jcarrus/MakeMITSelfBalancingRobot/segspecs/CAD/SolidWorks/segway1.jpg

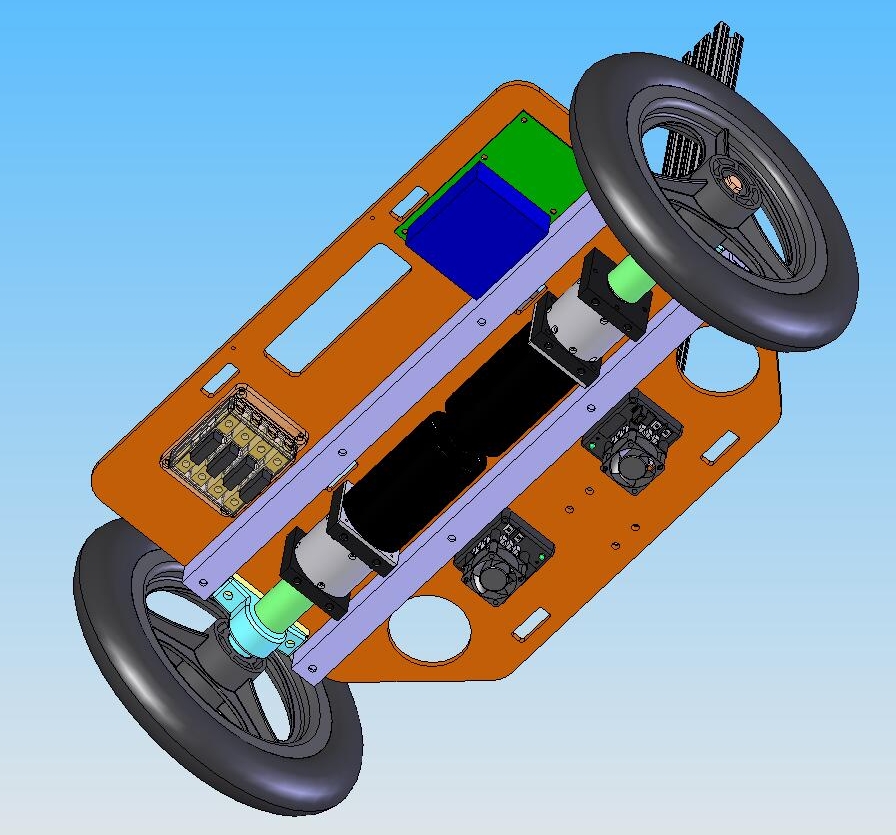
segspecs/CAD/SolidWorks/segway1.jpg
