jcarrus/MakeMITSelfBalancingRobot/segspecs/CAD/SolidWorks/segway2.jpg

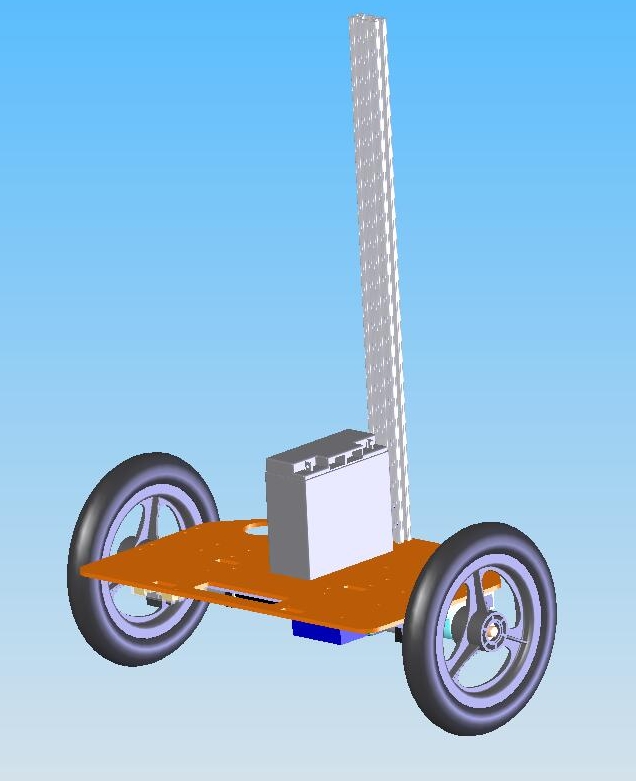
segspecs/CAD/SolidWorks/segway2.jpg
