jcarrus/MakeMITSelfBalancingRobot/README.md

MakeMITSelfBalancingRobot
=========================
