jcarrus/MakeMITSelfBalancingRobot/segspecs/CAD/SolidWorks/handlebar.jpg

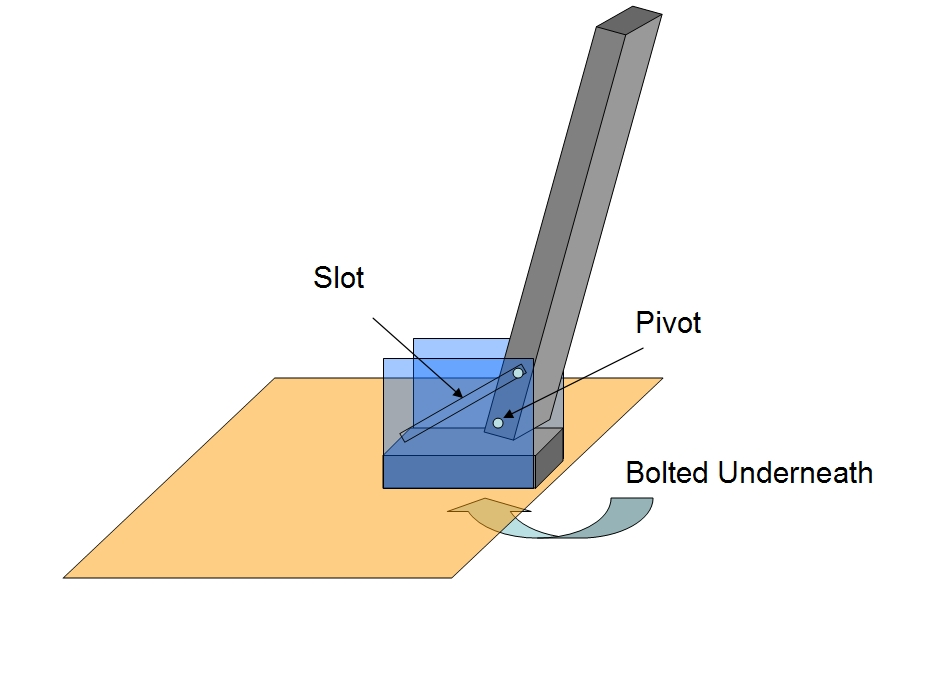
segspecs/CAD/SolidWorks/handlebar.jpg
