jcarrus/MakeMITSelfBalancingRobot/segspecs/CAD/SolidWorks/segway3.jpg

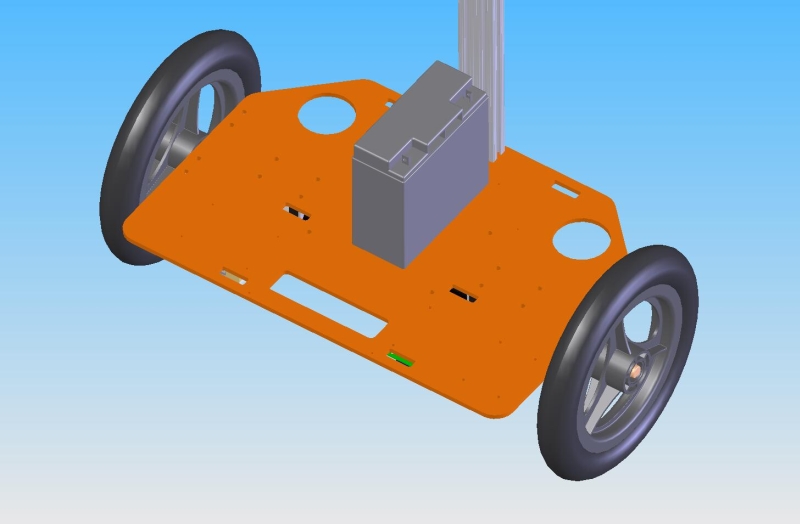
segspecs/CAD/SolidWorks/segway3.jpg
