jcarrus/MakeMITSelfBalancingRobot/segspecs/CAD/SolidWorks/segway4.jpg

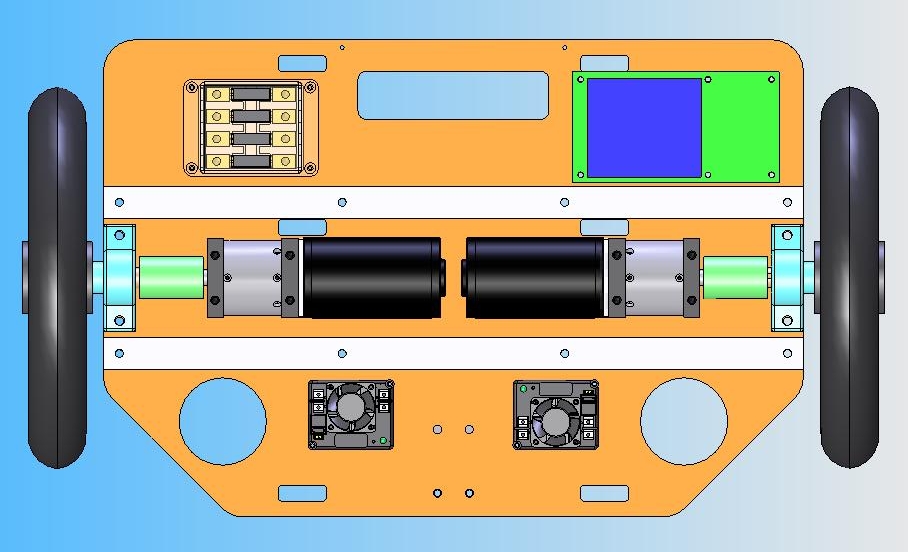
segspecs/CAD/SolidWorks/segway4.jpg
