jcarrus/MakeMITSelfBalancingRobot/segspecs/CAD/SolidWorks/teaser.jpg

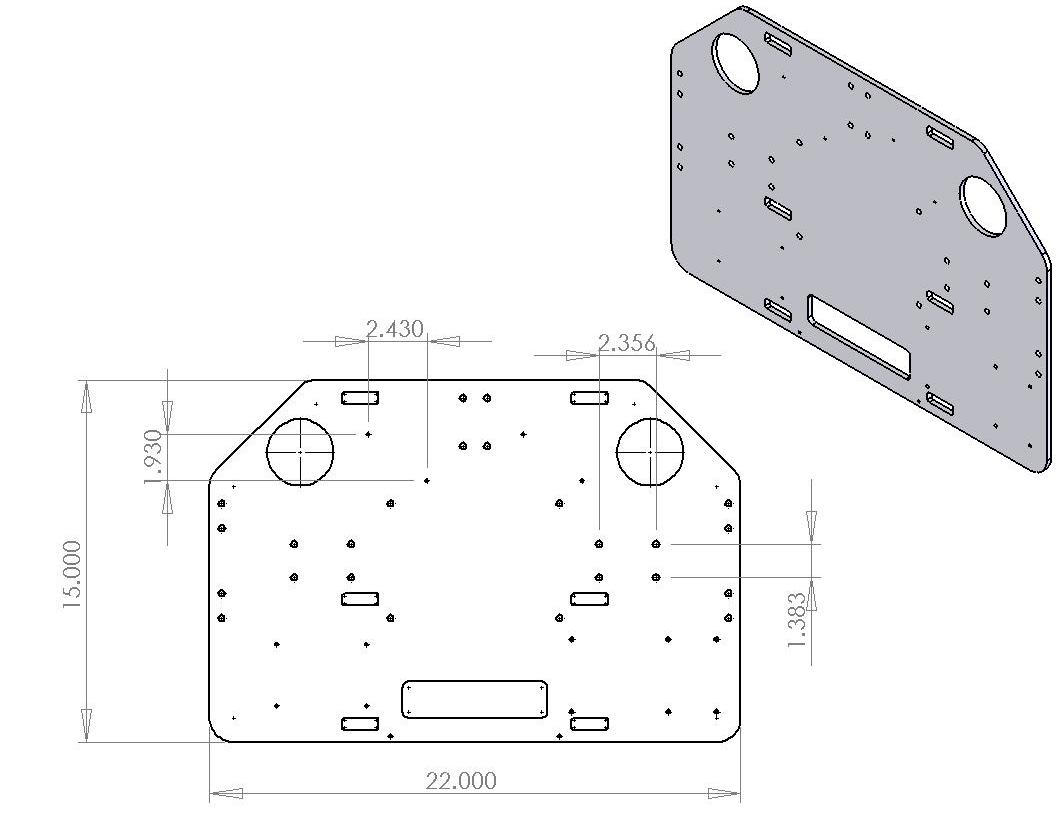
segspecs/CAD/SolidWorks/teaser.jpg
