jcarrus/MakeMITSelfBalancingRobot/segspecs/CAD/SolidWorks/12 Inch Wheel/12 Inch Wheel.SLDASM

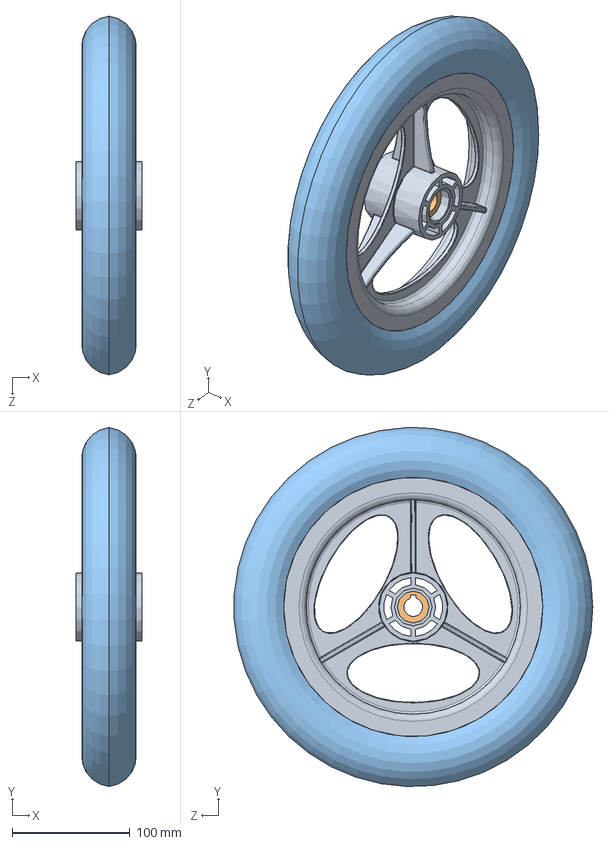
[picture p20: CAD file, 2014-02-15]
segspecs/CAD/SolidWorks/12 Inch Wheel/12 Inch Wheel.SLDASM
56.0 x 304.7 x 304.4 mm
12 Inch Wheel Outer Hub
12 Inch Wheel Inner Hub
12 Inch Tire
