jcarrus/MakeMITSelfBalancingRobot/segspecs/CAD/SolidWorks/BB-56012/BB2.SLDASM

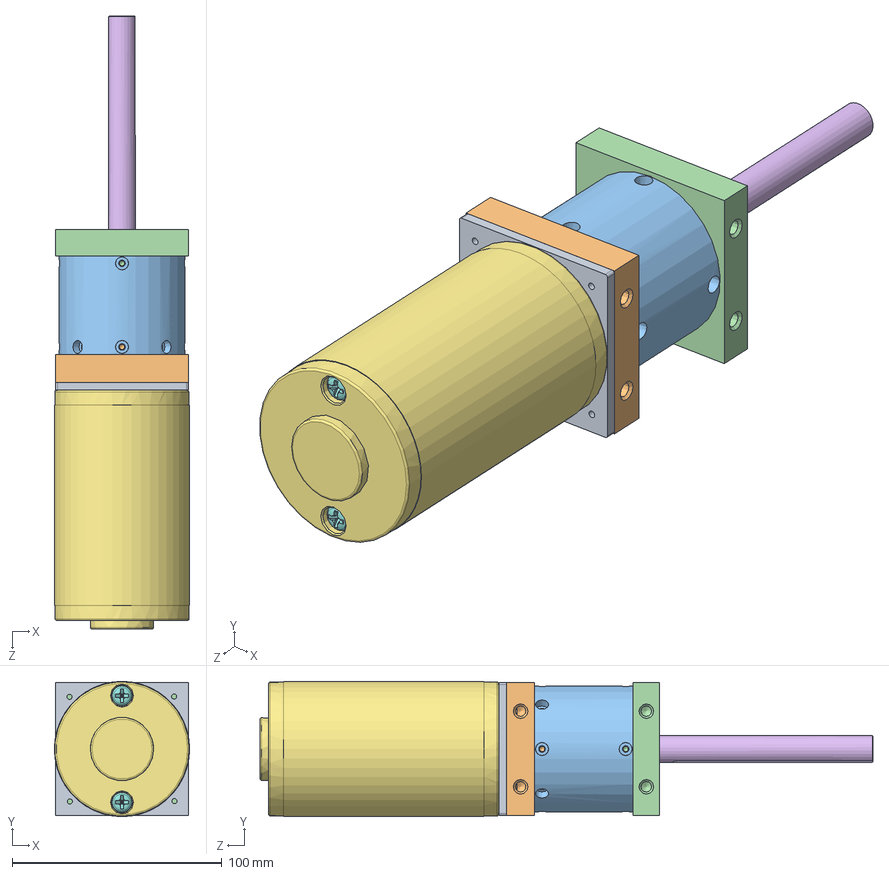
[picture p21: CAD file, 2014-02-15]
segspecs/CAD/SolidWorks/BB-56012/BB2.SLDASM
64.4 x 64.4 x 291.9 mm
BB2-InterfacePlate-1
BB2-BackPlate-1
BB2-RingGear-1
BB2-FrontPlate-1
br-8-1 x 2
BB2-OutputShaft-1
CIM motor-1
10-24 UNC x 4_ Phillips Pan Head-1 x 2
