jcarrus/MakeMITSelfBalancingRobot/segspecs/CAD/SolidWorks/Victor884/Victor884.SLDASM

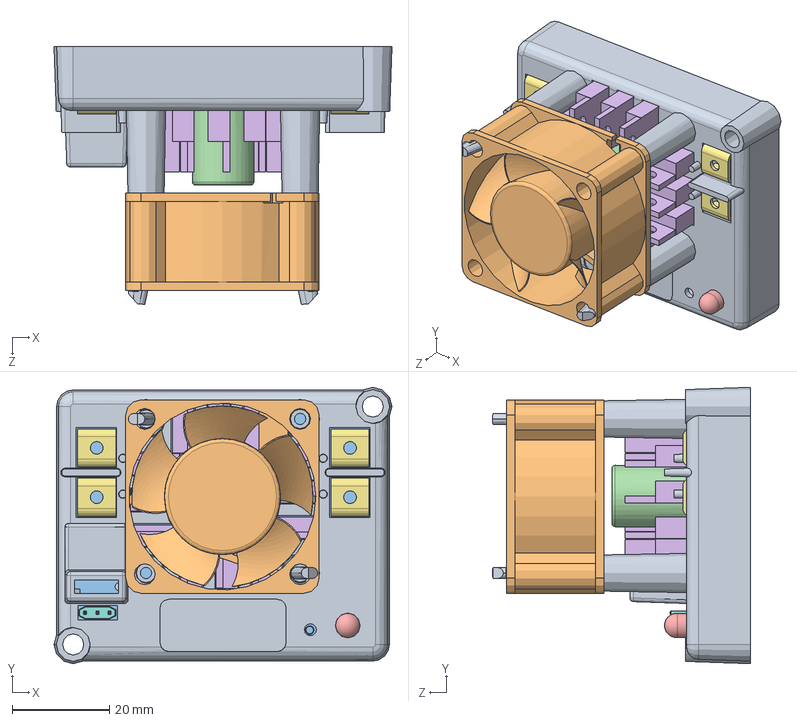
[picture p22: CAD file, 2014-02-15]
segspecs/CAD/SolidWorks/Victor884/Victor884.SLDASM
69.6 x 56.9 x 53.1 mm
Victor884-Cover
Fan-PAPST-412
Victor884-Base
Victor884-Capacitor
Victor884-LED - Green
Victor884-Fet x 12
Victor884 Screw Terminal x 4
Victor884-3 Pin Connector
