jcarrus/MakeMITSelfBalancingRobot/segspecs/CAD/SolidWorks/Maxi Fuse Block/Maxi Fuse Block.SLDASM

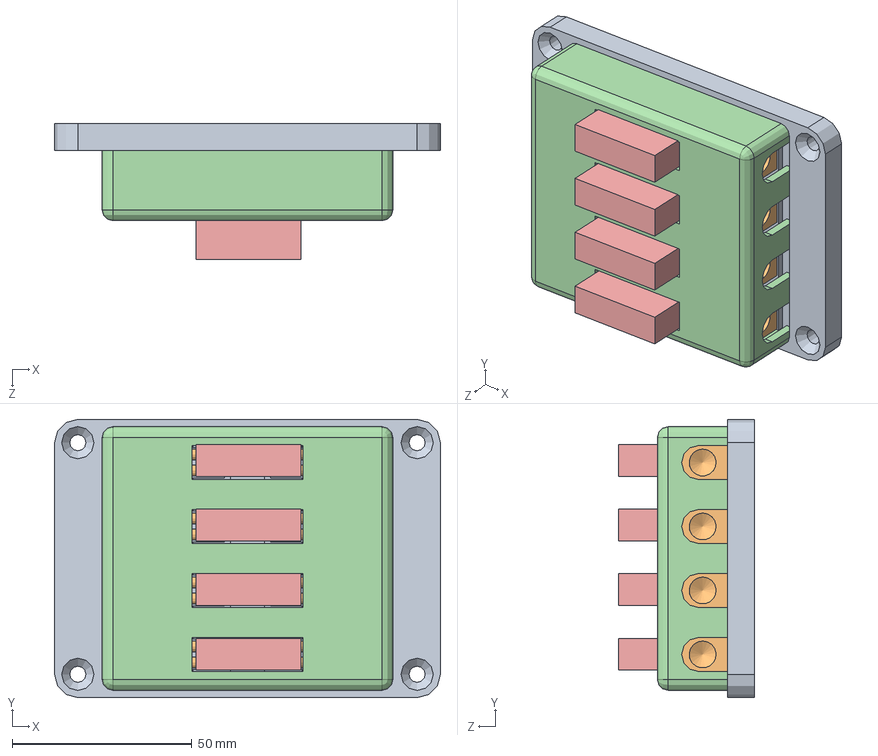
[picture p23: CAD file, 2014-02-15]
segspecs/CAD/SolidWorks/Maxi Fuse Block/Maxi Fuse Block.SLDASM
107.5 x 77.5 x 38.0 mm
Maxi Fuse Block - Base
Maxi Fuse Block - Terminal x 8
Maxi Fuse Block - Bottom Cover
Maxi Fuse Block - Top Cover
Maxi Fuse - Body x 4
Maxi Fuse - Terminal x 8
