jcarrus/MakeMITSelfBalancingRobot/segspecs/CAD/SolidWorks/victor883/victor883.SLDASM

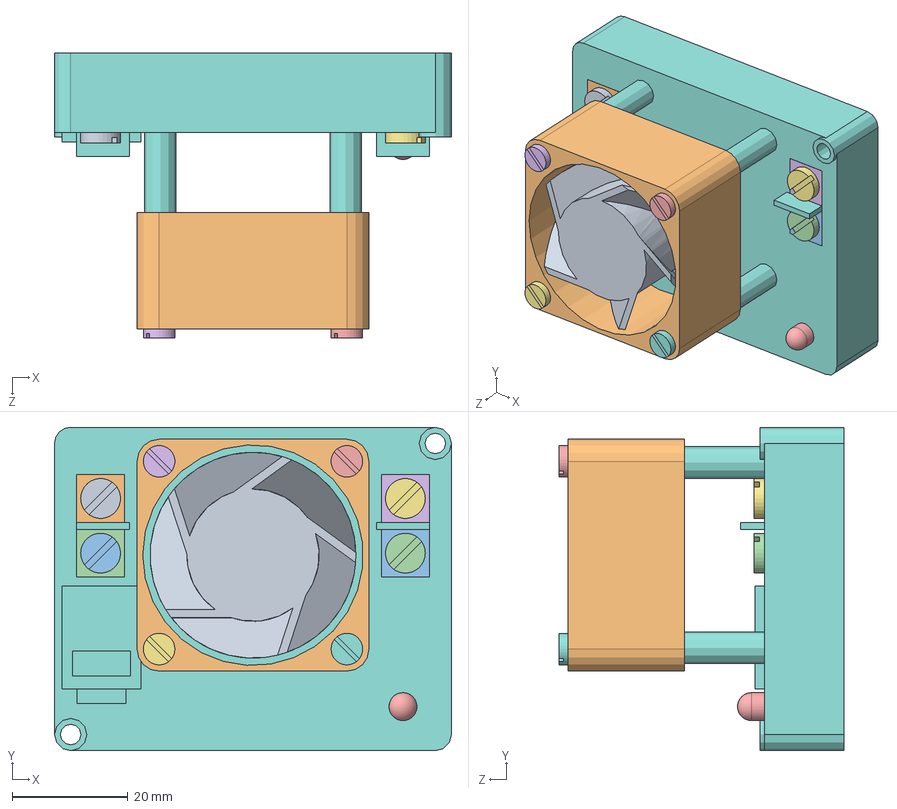
[picture p24: CAD file, 2014-02-15]
segspecs/CAD/SolidWorks/victor883/victor883.SLDASM
68.6 x 55.9 x 49.2 mm
victor8831
victor8832
victor8833
victor8834
victor8835
victor8836
victor8837
victor8838
victor8839
victor88310
victor88311
victor88312
victor88313
victor88314
victor88315
victor88316
