jcarrus/MakeMITSelfBalancingRobot/segspecs/CAD/SolidWorks/Segway.SLDASM

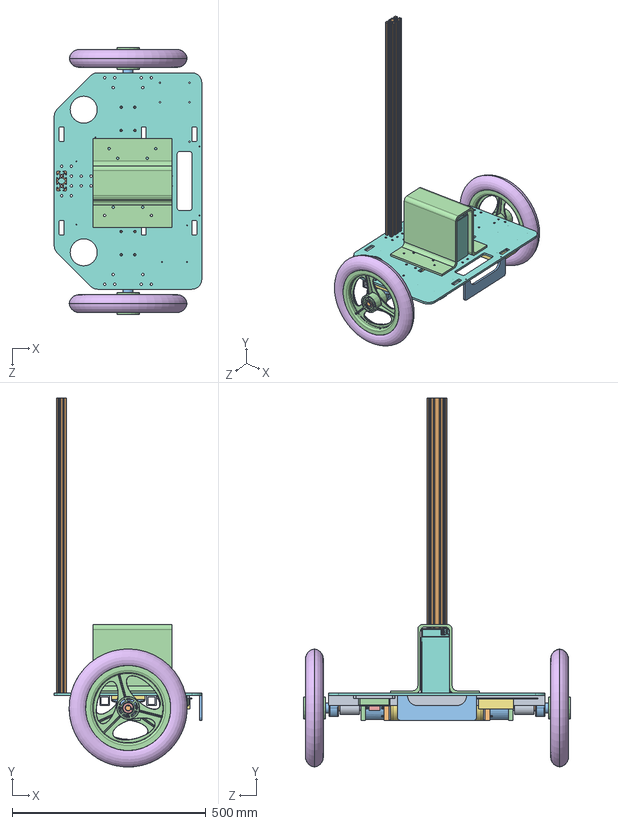
[picture p25: CAD file, 2014-02-15]
segspecs/CAD/SolidWorks/Segway.SLDASM
381.0 x 952.4 x 688.7 mm
BB2-InterfacePlate-1 x 2
BB2-BackPlate-1 x 2
BB2-RingGear-1 x 2
BB2-FrontPlate-1 x 2
br-8-1 x 4
BB2-OutputShaft-1 x 2
CIM motor-1 x 2
10-24 UNC x 4_ Phillips Pan Head-1 x 4
coupling x 2
5_8_keyed_shaft x 2
bearing x 2
12 Inch Wheel Outer Hub x 2
12 Inch Wheel Inner Hub x 2
12 Inch Tire x 2
bearing spacer x 2
battery
Maxi Fuse Block - Base
Maxi Fuse Block - Terminal x 8
Maxi Fuse Block - Bottom Cover
Maxi Fuse Block - Top Cover
Maxi Fuse - Body x 4
Maxi Fuse - Terminal x 8
Victor884-Cover x 2
Fan-PAPST-412 x 2
Victor884-Base x 2
Victor884-Capacitor x 2
Victor884-LED - Green x 2
Victor884-Fet x 24
Victor884 Screw Terminal x 8
Victor884-3 Pin Connector x 2
controller
base
beam x 2
8020-1020-36in
plate
batteryholder
