jcarrus/MakeMITSelfBalancingRobot/segspecs/CAD/SolidWorks/8020-1010/8020-36in.SLDPRT

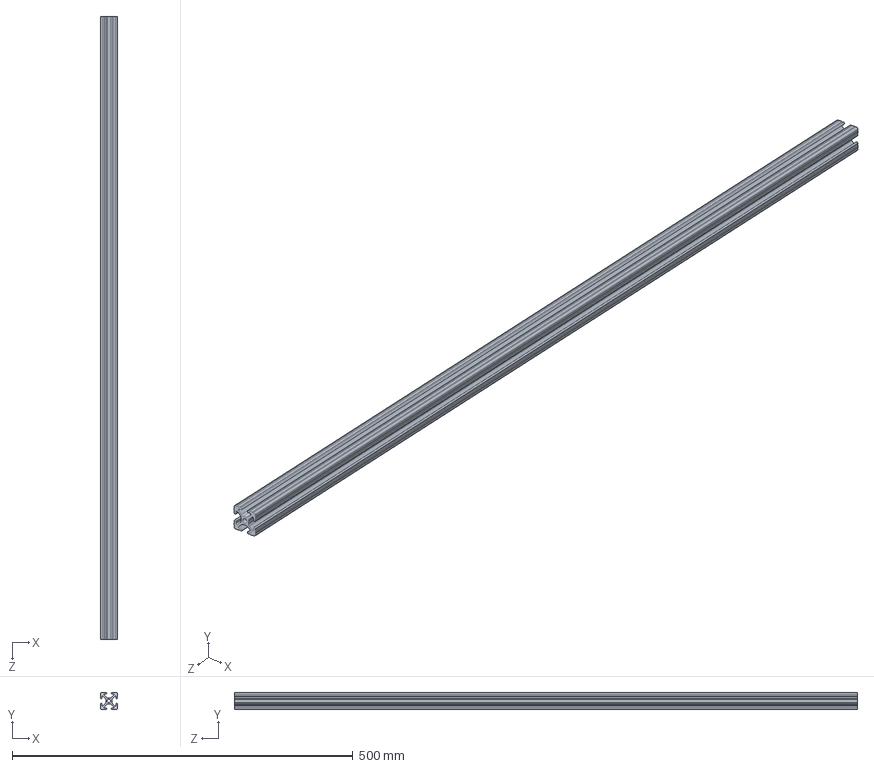
[picture p26: CAD file, 2014-02-15]
segspecs/CAD/SolidWorks/8020-1010/8020-36in.SLDPRT
25.4 x 25.4 x 914.4 mm
