jcarrus/MakeMITSelfBalancingRobot/segspecs/CAD/SolidWorks/8020-1020/8020-1020-36in.SLDPRT

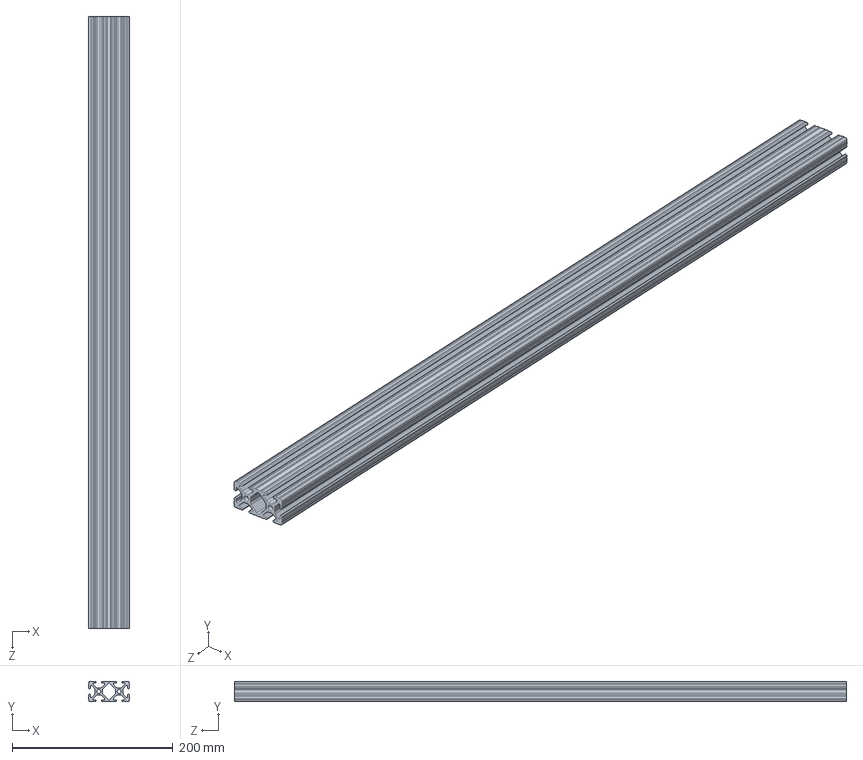
[picture p27: CAD file, 2014-02-15]
segspecs/CAD/SolidWorks/8020-1020/8020-1020-36in.SLDPRT
50.8 x 25.4 x 762.0 mm
