jcarrus/MakeMITSelfBalancingRobot/segspecs/CAD/SolidWorks/battery/battery.SLDPRT

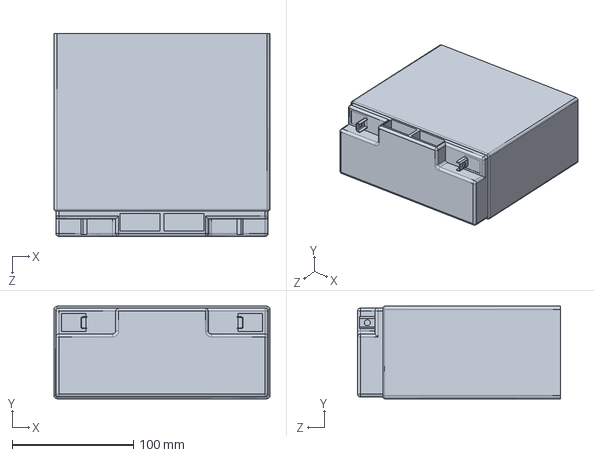
[picture p28: CAD file, 2014-02-15]
segspecs/CAD/SolidWorks/battery/battery.SLDPRT
177.8 x 76.2 x 167.1 mm
