jcarrus/MakeMITSelfBalancingRobot/segspecs/CAD/SolidWorks/bearing.sldprt

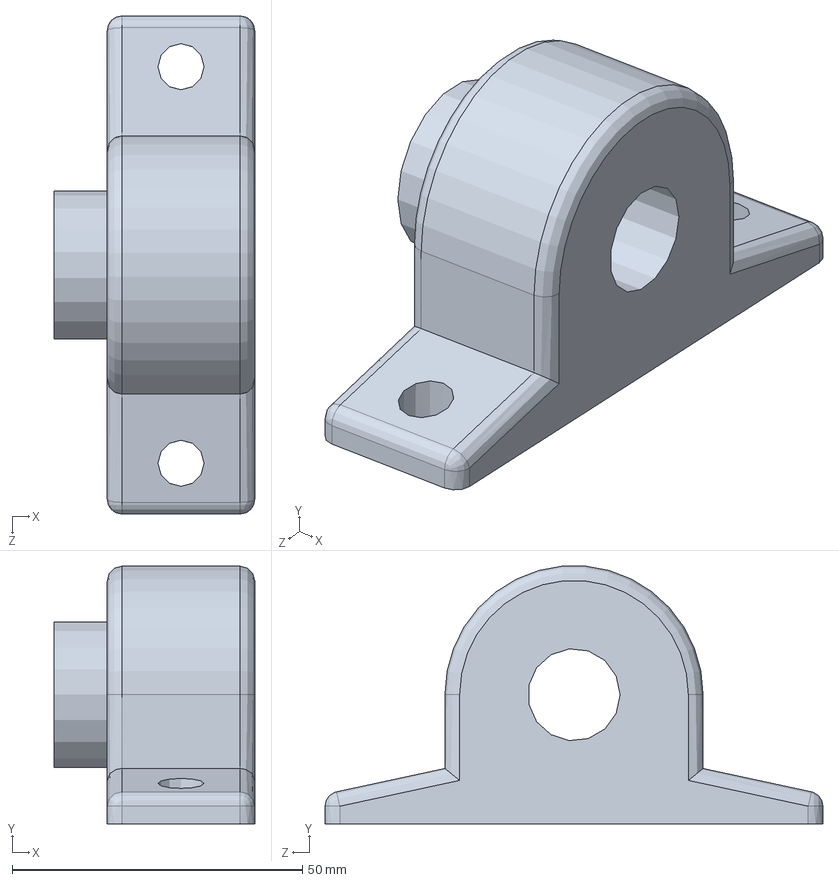
[picture p29: CAD file, 2014-02-15]
segspecs/CAD/SolidWorks/bearing.sldprt
34.5 x 44.4 x 85.7 mm
