jcarrus/MakeMITSelfBalancingRobot/segspecs/CAD/SolidWorks/segway_waterjet/segway5.dxf

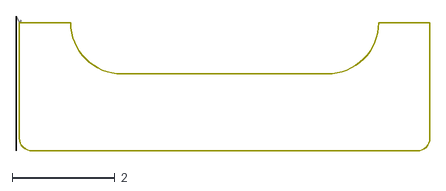
[picture p30: CAD file, 2014-02-15]
segspecs/CAD/SolidWorks/segway_waterjet/segway5.dxf
8.06 x 2.63
