jcarrus/MakeMITSelfBalancingRobot/segspecs/CAD/SolidWorks/8020-1010/8020-1010.igs

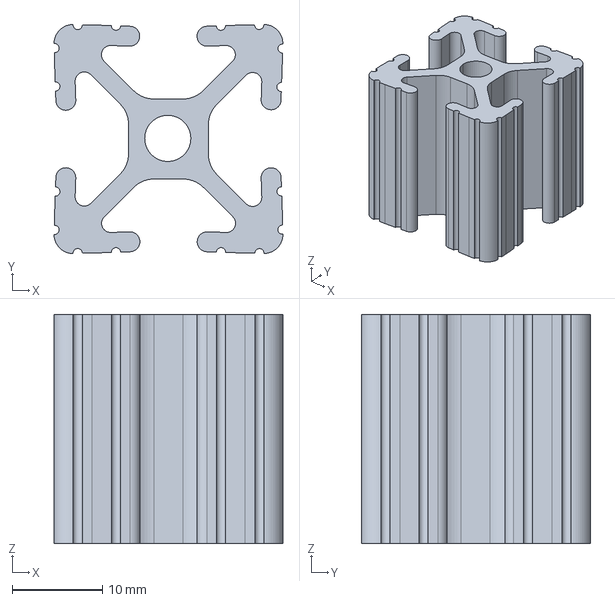
[picture p31: CAD file, 2014-02-15]
segspecs/CAD/SolidWorks/8020-1010/8020-1010.igs
25.4 x 25.4 x 25.4 mm
