jcarrus/MakeMITSelfBalancingRobot/segspecs/CAD/SolidWorks/8020-1020/8020-1020.igs

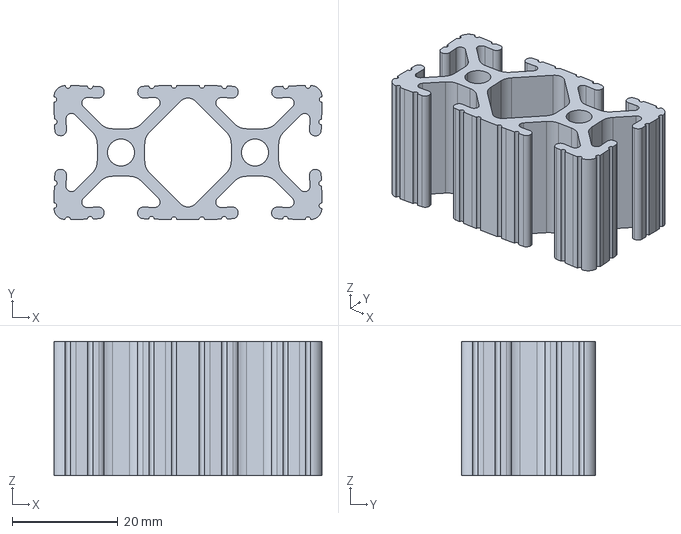
[picture p32: CAD file, 2014-02-15]
segspecs/CAD/SolidWorks/8020-1020/8020-1020.igs
50.8 x 25.4 x 25.4 mm
