jcarrus/MakeMITSelfBalancingRobot/segspecs/CAD/SolidWorks/coupling.SLDPRT

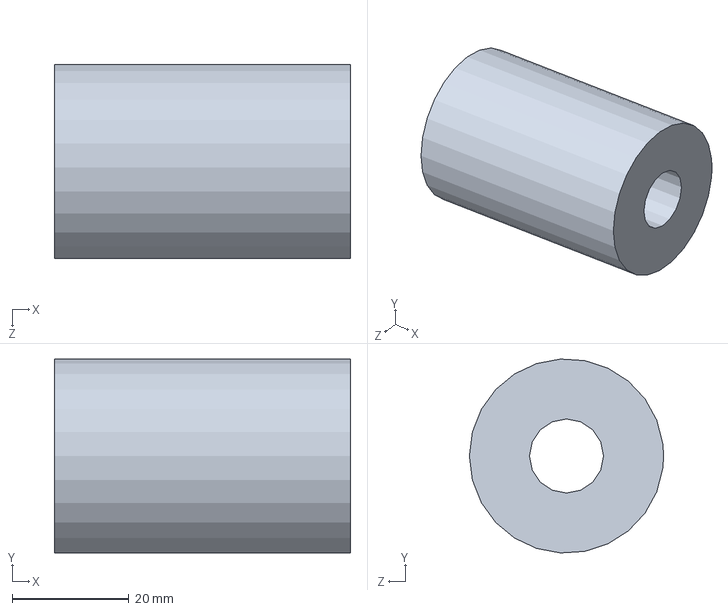
[picture p33: CAD file, 2014-02-15]
segspecs/CAD/SolidWorks/coupling.SLDPRT
50.8 x 33.3 x 33.3 mm
