jcarrus/MakeMITSelfBalancingRobot/segspecs/CAD/SolidWorks/segway_waterjet/base braket_waterjet.DXF

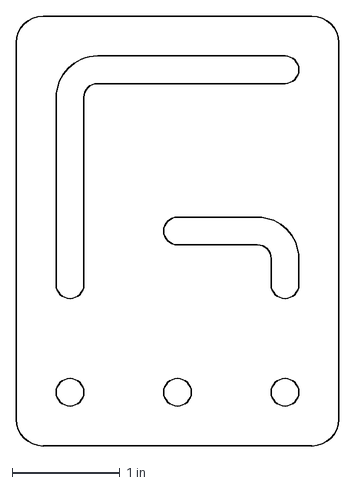
[picture p34: CAD file, 2014-02-15]
segspecs/CAD/SolidWorks/segway_waterjet/base braket_waterjet.DXF
3.00 x 4.00 in
