jcarrus/MakeMITSelfBalancingRobot/segspecs/CAD/SolidWorks/ADXRS401EB.SLDPRT

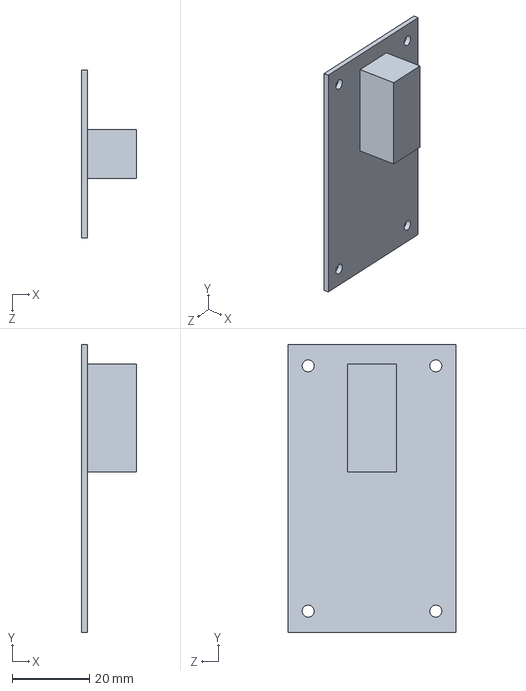
[picture p35: CAD file, 2014-02-15]
segspecs/CAD/SolidWorks/ADXRS401EB.SLDPRT
14.3 x 74.5 x 43.5 mm
