jcarrus/MakeMITSelfBalancingRobot/segspecs/CAD/SolidWorks/segway_waterjet/segway4.dxf

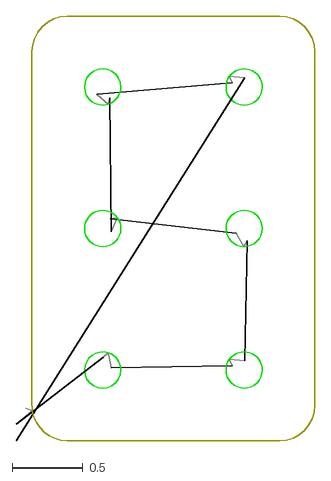
[picture p36: CAD file, 2014-02-15]
segspecs/CAD/SolidWorks/segway_waterjet/segway4.dxf
2.11 x 3.00
