jcarrus/MakeMITSelfBalancingRobot/segspecs/CAD/SolidWorks/Segway_waterjet.DXF

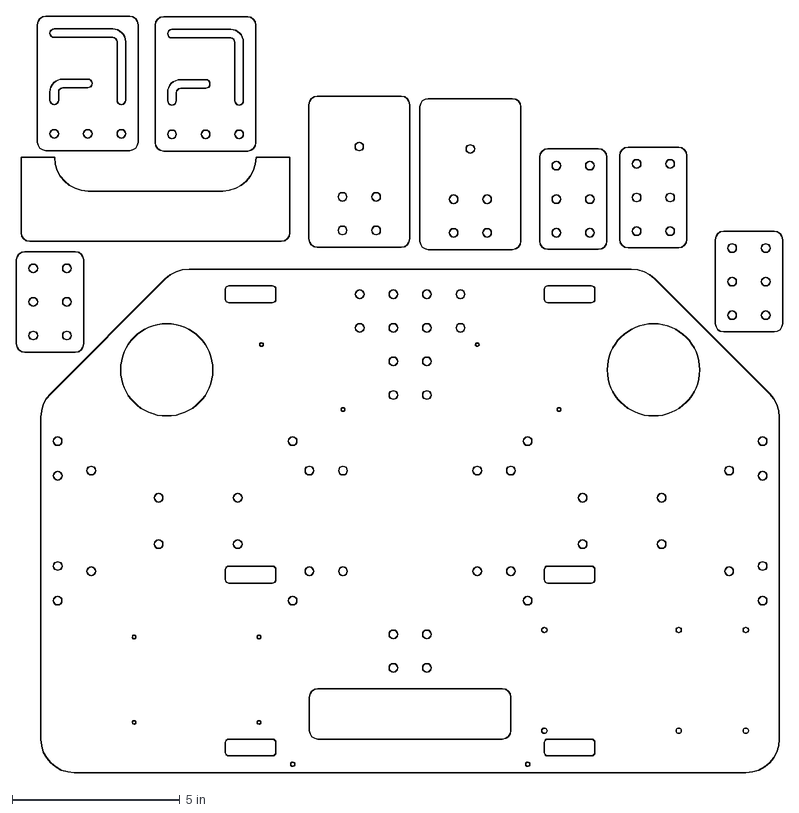
[picture p37: CAD file, 2014-02-15]
segspecs/CAD/SolidWorks/Segway_waterjet.DXF
22.8 x 22.5 in
