jcarrus/MakeMITSelfBalancingRobot/segspecs/CAD/SolidWorks/segway_waterjet/base_waterjet.DXF

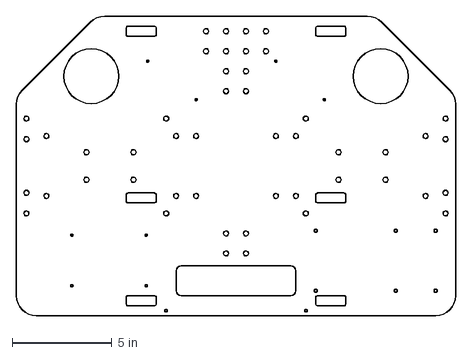
[picture p38: CAD file, 2014-02-15]
segspecs/CAD/SolidWorks/segway_waterjet/base_waterjet.DXF
22.0 x 15.0 in
