jcarrus/MakeMITSelfBalancingRobot/segspecs/CAD/SolidWorks/ADXL203EB.SLDPRT

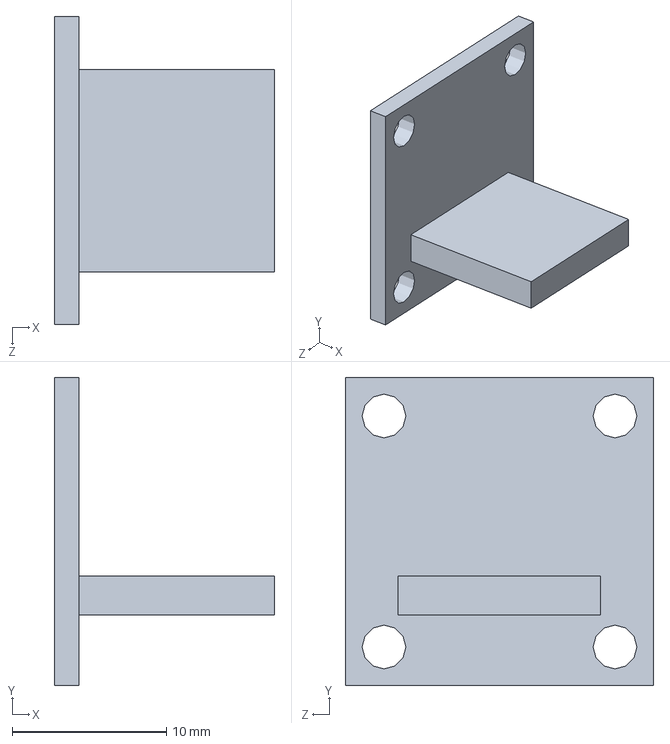
[picture p39: CAD file, 2014-02-15]
segspecs/CAD/SolidWorks/ADXL203EB.SLDPRT
14.3 x 20.0 x 20.0 mm
