jcarrus/MakeMITSelfBalancingRobot/segspecs/CAD/SolidWorks/segway_waterjet/3x2bracket_waterjet.DXF

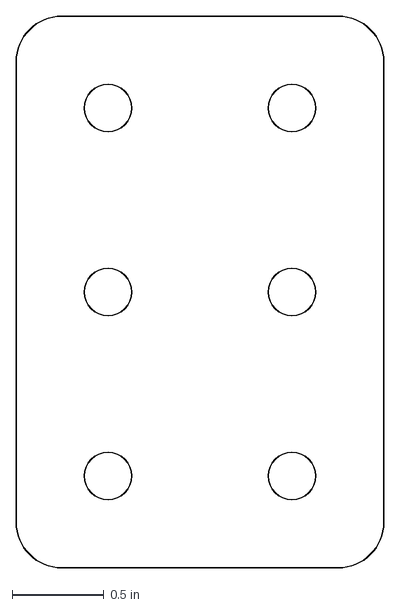
[picture p40: CAD file, 2014-02-15]
segspecs/CAD/SolidWorks/segway_waterjet/3x2bracket_waterjet.DXF
2.00 x 3.00 in
