jcarrus/MakeMITSelfBalancingRobot/segspecs/CAD/SolidWorks/plate.SLDPRT

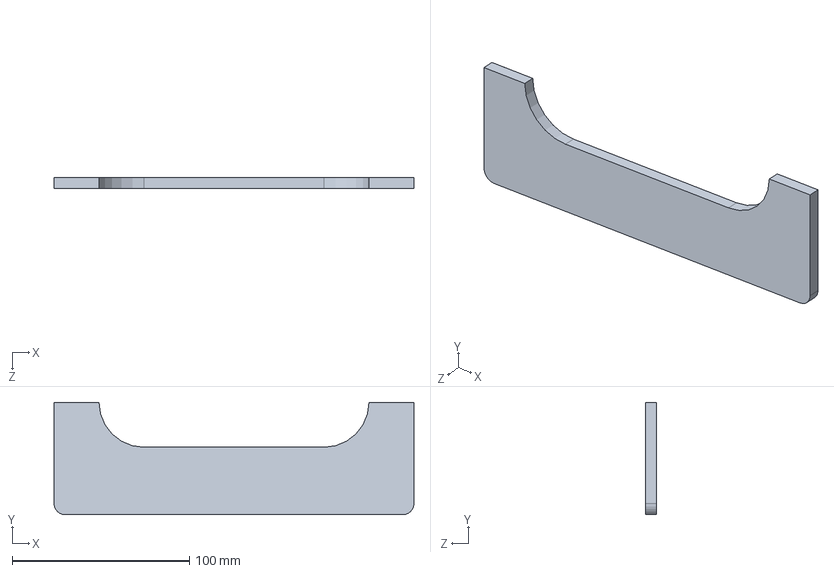
[picture p41: CAD file, 2014-02-15]
segspecs/CAD/SolidWorks/plate.SLDPRT
203.2 x 63.5 x 6.35 mm
