jcarrus/MakeMITSelfBalancingRobot/segspecs/CAD/SolidWorks/segway_waterjet/pivot__waterjet.DXF

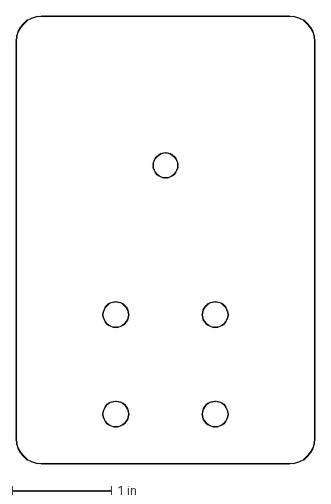
[picture p42: CAD file, 2014-02-15]
segspecs/CAD/SolidWorks/segway_waterjet/pivot__waterjet.DXF
3.00 x 4.50 in
