jcarrus/MakeMITSelfBalancingRobot/segspecs/CAD/SolidWorks/5_8_keyed_shaft.SLDPRT

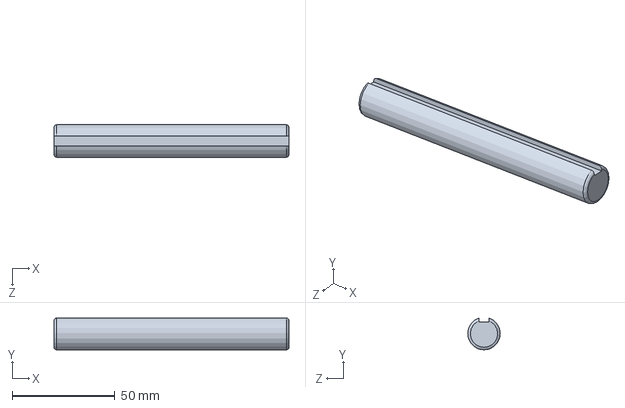
[picture p43: CAD file, 2014-02-15]
segspecs/CAD/SolidWorks/5_8_keyed_shaft.SLDPRT
114.3 x 15.5 x 15.9 mm
