jcarrus/MakeMITSelfBalancingRobot/segspecs/CAD/SolidWorks/segway_waterjet/segway2.dxf

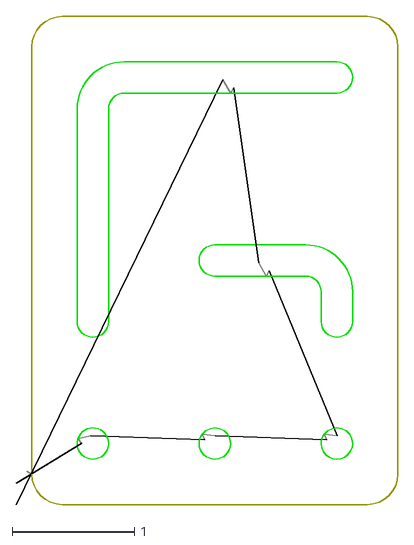
[picture p44: CAD file, 2014-02-15]
segspecs/CAD/SolidWorks/segway_waterjet/segway2.dxf
3.13 x 4.00
