jcarrus/MakeMITSelfBalancingRobot/segspecs/CAD/SolidWorks/controller.SLDPRT

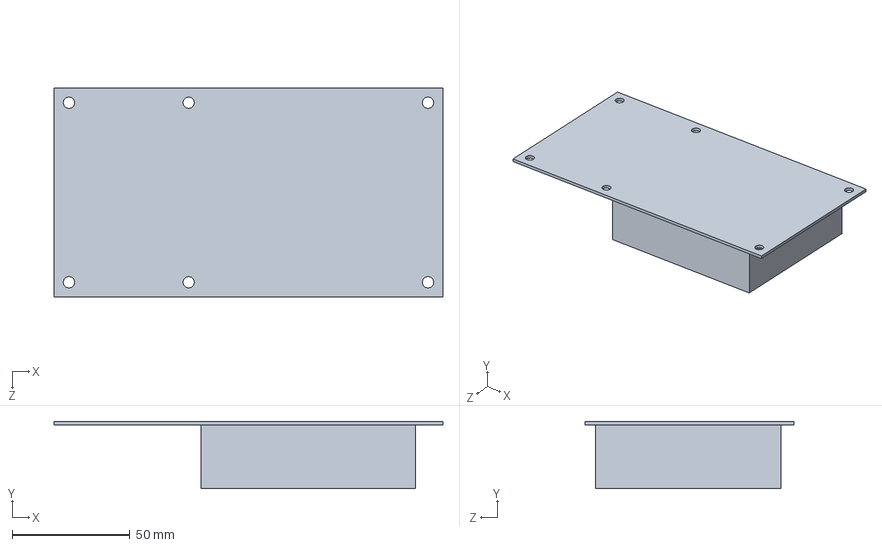
[picture p45: CAD file, 2014-02-15]
segspecs/CAD/SolidWorks/controller.SLDPRT
165.1 x 28.6 x 88.9 mm
