jcarrus/MakeMITSelfBalancingRobot/segspecs/CAD/SolidWorks/segway_waterjet/segway3.dxf

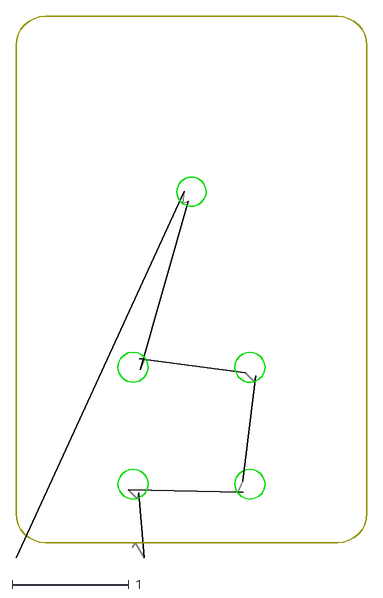
[picture p46: CAD file, 2014-02-15]
segspecs/CAD/SolidWorks/segway_waterjet/segway3.dxf
3.00 x 4.63
