jcarrus/MakeMITSelfBalancingRobot/segspecs/CAD/SolidWorks/pin block.SLDPRT

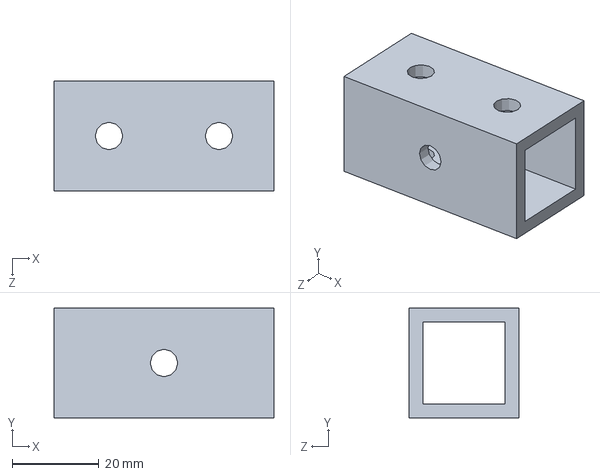
[picture p47: CAD file, 2014-02-15]
segspecs/CAD/SolidWorks/pin block.SLDPRT
50.8 x 25.4 x 25.4 mm
