jcarrus/MakeMITSelfBalancingRobot/segspecs/CAD/SolidWorks/segway_waterjet/plate_waterjet.DXF

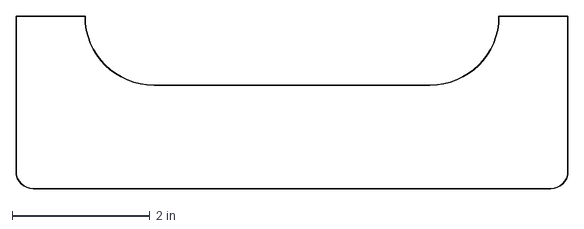
[picture p48: CAD file, 2014-02-15]
segspecs/CAD/SolidWorks/segway_waterjet/plate_waterjet.DXF
8.00 x 2.50 in
