jcarrus/MakeMITSelfBalancingRobot/segspecs/CAD/SolidWorks/segway_waterjet/segway1.dxf

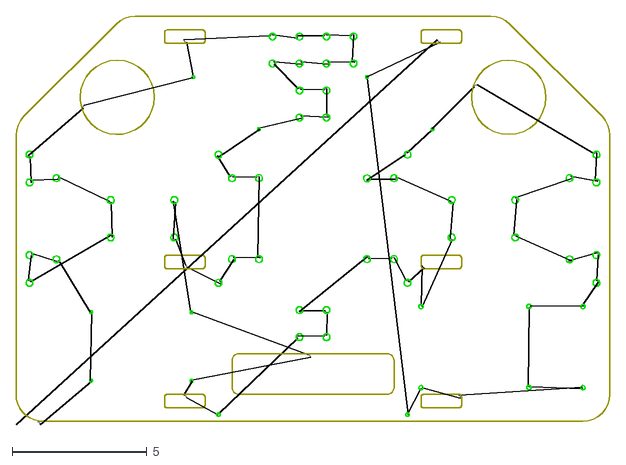
[picture p49: CAD file, 2014-02-15]
segspecs/CAD/SolidWorks/segway_waterjet/segway1.dxf
22.0 x 15.1
