jcarrus/MakeMITSelfBalancingRobot/segspecs/CAD/SolidWorks/segway_waterjet/segway.dxf

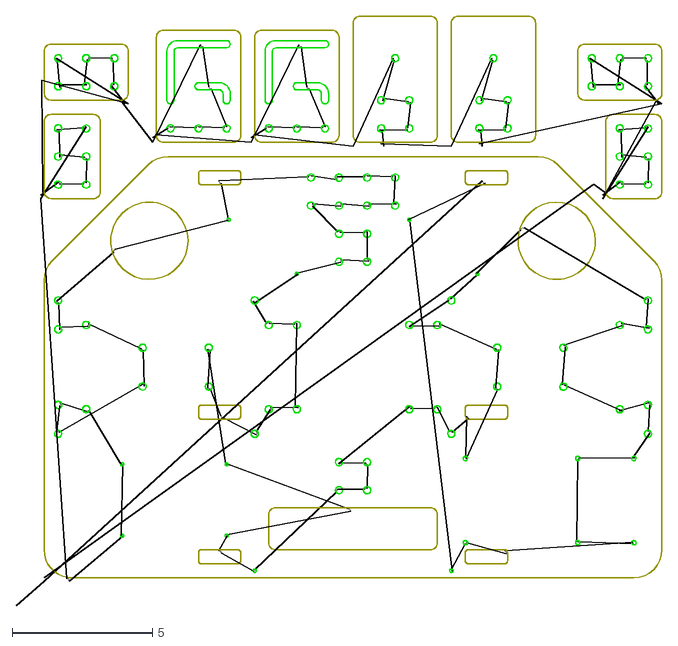
[picture p50: CAD file, 2014-02-15]
segspecs/CAD/SolidWorks/segway_waterjet/segway.dxf
23.0 x 21.0
