jcarrus/MakeMITSelfBalancingRobot/segspecs/CAD/SolidWorks/beam.SLDPRT

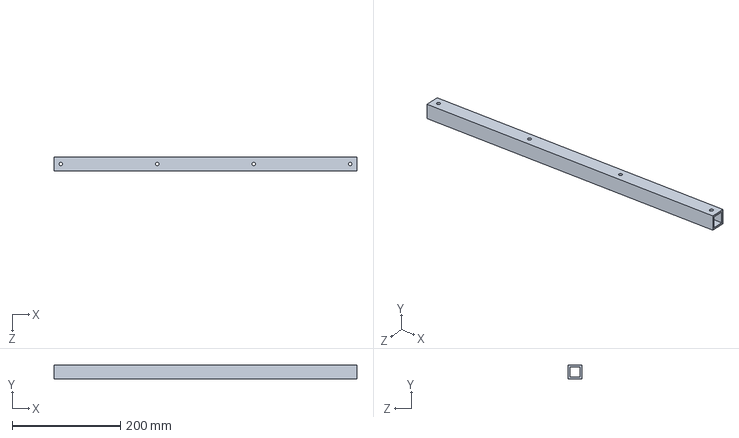
[picture p51: CAD file, 2014-02-15]
segspecs/CAD/SolidWorks/beam.SLDPRT
558.8 x 25.4 x 25.4 mm
