jcarrus/MakeMITSelfBalancingRobot/segspecs/CAD/SolidWorks/base braket.SLDPRT

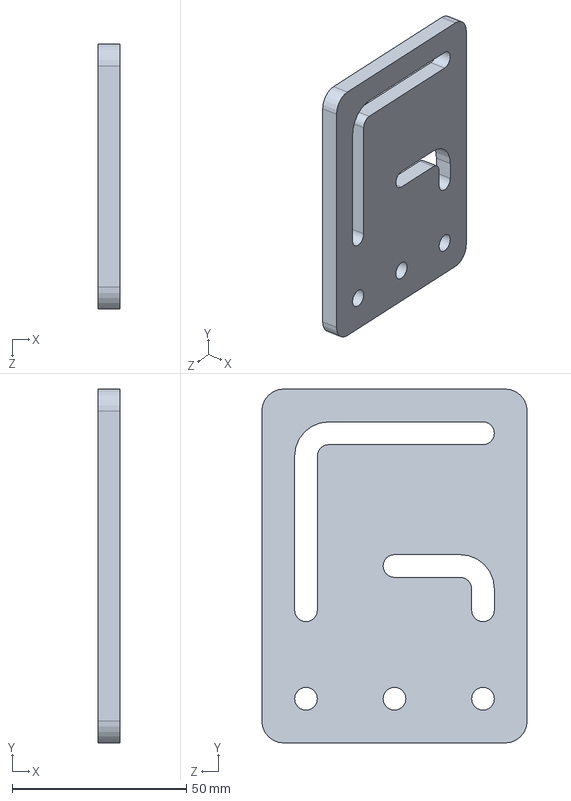
[picture p52: CAD file, 2014-02-15]
segspecs/CAD/SolidWorks/base braket.SLDPRT
6.35 x 101.6 x 76.2 mm
