jcarrus/MakeMITSelfBalancingRobot/segspecs/CAD/SolidWorks/bearing spacer.SLDPRT

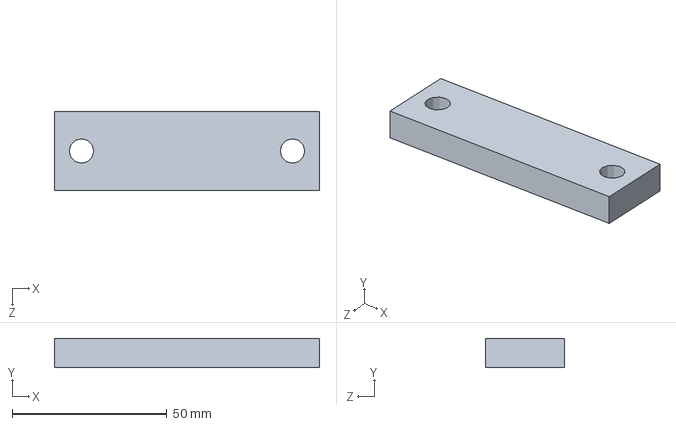
[picture p53: CAD file, 2014-02-15]
segspecs/CAD/SolidWorks/bearing spacer.SLDPRT
85.7 x 9.53 x 25.4 mm
