jcarrus/MakeMITSelfBalancingRobot/segspecs/CAD/SolidWorks/3x2bracket.SLDPRT

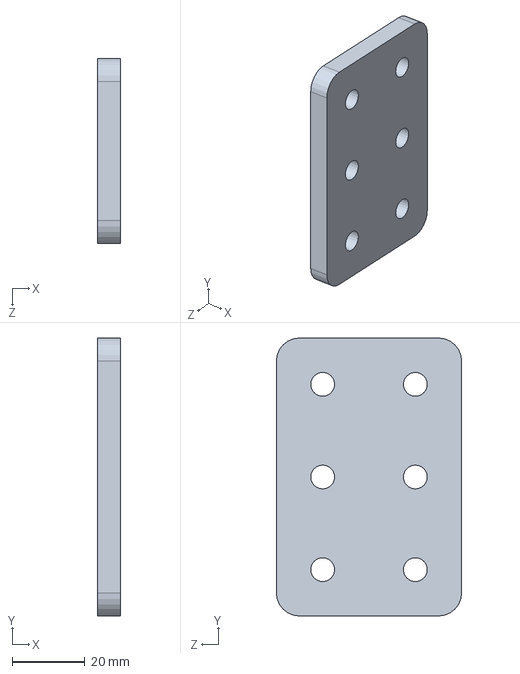
[picture p54: CAD file, 2014-02-15]
segspecs/CAD/SolidWorks/3x2bracket.SLDPRT
6.35 x 76.2 x 50.8 mm
