jcarrus/MakeMITSelfBalancingRobot/segspecs/CAD/SolidWorks/pivot.SLDPRT

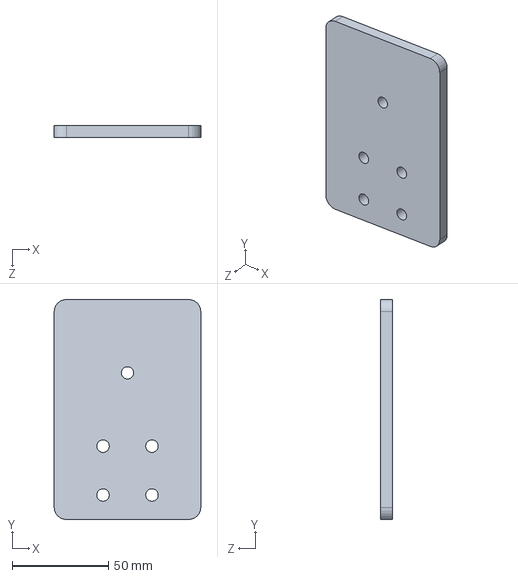
[picture p55: CAD file, 2014-02-15]
segspecs/CAD/SolidWorks/pivot.SLDPRT
76.2 x 114.3 x 6.35 mm
