jcarrus/MakeMITSelfBalancingRobot/segspecs/CAD/SolidWorks/base.sldprt

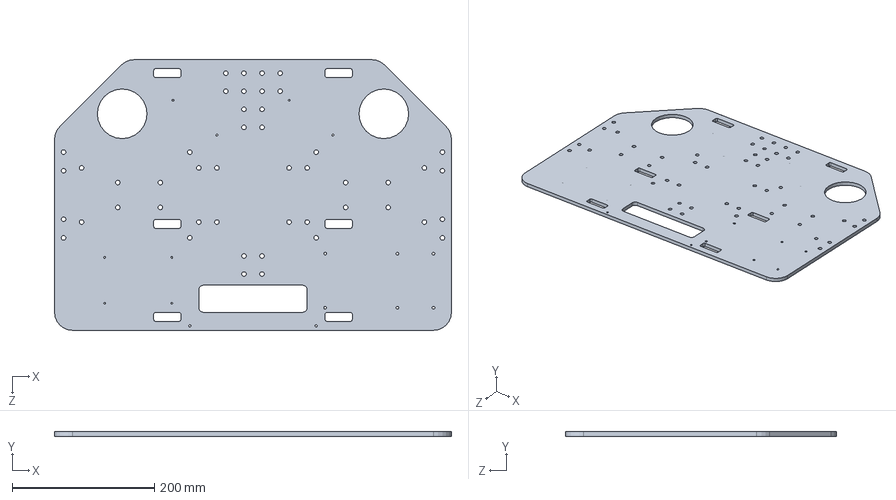
[picture p56: CAD file, 2014-02-15]
segspecs/CAD/SolidWorks/base.sldprt
558.8 x 6.35 x 381.0 mm
