jcarrus/MakeMITSelfBalancingRobot/segspecs/CAD/SolidWorks/batteryholder.SLDPRT

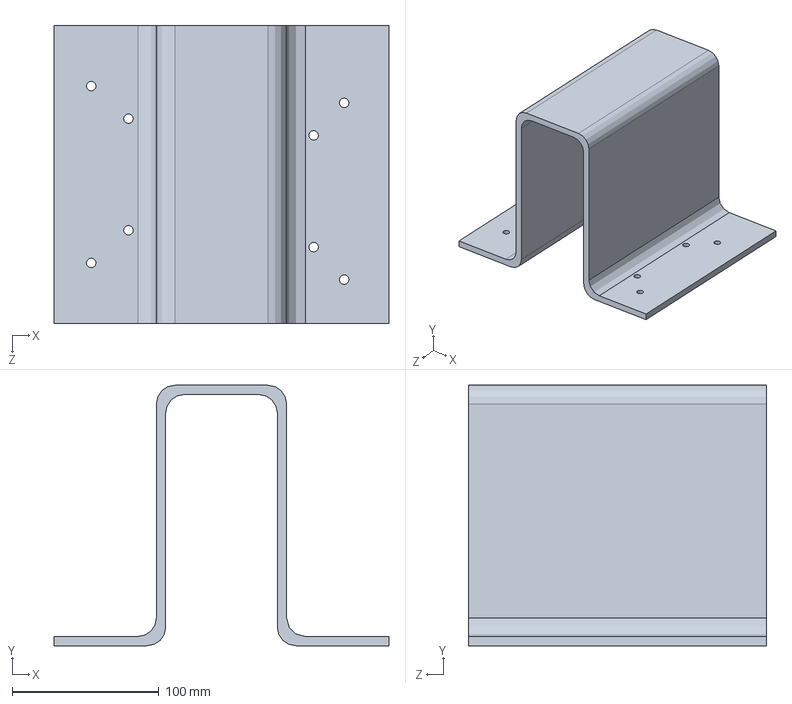
[picture p57: CAD file, 2014-02-15]
segspecs/CAD/SolidWorks/batteryholder.SLDPRT
228.6 x 177.8 x 203.2 mm
