jcarrus/MakeMITSelfBalancingRobot/(list of files, cad)

Other CAD files:
segspecs/CAD/SolidWorks/BB-56012/CIM Motor.sldasm
segspecs/CAD/SolidWorks/Maxi Fuse Block/Maxi Fuse.sldasm
segspecs/CAD/SolidWorks/BB-56012/CIM Motor-1.sldasm
segspecs/CAD/SolidWorks/Maxi Fuse Block/Maxi Fuse - Terminal.sldprt
segspecs/CAD/SolidWorks/victor883/victor88312.sldprt
segspecs/CAD/SolidWorks/12 Inch Wheel/12 Inch Wheel Outer Hub.sldprt
segspecs/CAD/SolidWorks/Maxi Fuse Block/Maxi Fuse Block - Terminal.sldprt
segspecs/CAD/SolidWorks/victor883/victor8838.sldprt
segspecs/CAD/SolidWorks/12 Inch Wheel/12 Inch Tire.sldprt
segspecs/CAD/SolidWorks/BB-56012/BB2-InterfacePlate-1.sldprt
segspecs/CAD/SolidWorks/victor883/victor88310.sldprt
segspecs/CAD/SolidWorks/Victor884/Victor884-LED - Green.sldprt
segspecs/CAD/SolidWorks/12 Inch Wheel/12 Inch Wheel Inner Hub.sldprt
segspecs/CAD/SolidWorks/BB-56012/BB2-RingGear-1.sldprt
segspecs/CAD/SolidWorks/victor883/victor88315.sldprt
segspecs/CAD/SolidWorks/Victor884/Fan-PAPST-412.sldprt
segspecs/CAD/SolidWorks/BB-56012/BB2-OutputShaft-1.sldprt
segspecs/CAD/SolidWorks/Maxi Fuse Block/Maxi Fuse Block - Bottom Cover.sldprt
segspecs/CAD/SolidWorks/victor883/victor88314.sldprt
segspecs/CAD/SolidWorks/Victor884/Victor884-Base.sldprt
segspecs/CAD/SolidWorks/BB-56012/BB2-BackPlate-1.sldprt
segspecs/CAD/SolidWorks/Maxi Fuse Block/Maxi Fuse - Body.sldprt
segspecs/CAD/SolidWorks/victor883/victor8837.sldprt
segspecs/CAD/SolidWorks/Victor884/Victor884-Capacitor.sldprt
segspecs/CAD/SolidWorks/BB-56012/br-8.sldprt
segspecs/CAD/SolidWorks/Maxi Fuse Block/Maxi Fuse Block - Top Cover.sldprt
segspecs/CAD/SolidWorks/victor883/victor88311.sldprt
segspecs/CAD/SolidWorks/Victor884/Victor884-Cover.sldprt
segspecs/CAD/SolidWorks/BB-56012/BB2-InterfacePlate.sldprt
segspecs/CAD/SolidWorks/Maxi Fuse Block/Maxi Fuse Block - Base.sldprt
segspecs/CAD/SolidWorks/Victor884/Victor884-Fet.sldprt
segspecs/CAD/SolidWorks/BB-56012/BB2-RingGear.sldprt
segspecs/CAD/SolidWorks/victor883/victor88316.sldprt
segspecs/CAD/SolidWorks/Victor884/Victor884-3 Pin Connector.sldprt
segspecs/CAD/SolidWorks/BB-56012/BB2-OutputShaft.sldprt
segspecs/CAD/SolidWorks/victor883/victor8834.sldprt
segspecs/CAD/SolidWorks/victor883/victor8835.sldprt
segspecs/CAD/SolidWorks/BB-56012/10-24 UNC x 4_ Phillips Pan Head-1.sldprt
segspecs/CAD/SolidWorks/victor883/victor88313.sldprt
segspecs/CAD/SolidWorks/BB-56012/BB2-BackPlate.sldprt
segspecs/CAD/SolidWorks/victor883/victor8836.sldprt
segspecs/CAD/SolidWorks/BB-56012/BB2-FrontPlate-1.sldprt
segspecs/CAD/SolidWorks/victor883/victor8832.sldprt
segspecs/CAD/SolidWorks/BB-56012/10-24 UNC x 4_ Phillips Pan Head.sldprt
segspecs/CAD/SolidWorks/victor883/victor8831.sldprt
segspecs/CAD/SolidWorks/BB-56012/br-8-1.sldprt
segspecs/CAD/SolidWorks/victor883/victor8839.sldprt
segspecs/CAD/SolidWorks/BB-56012/BB2-FrontPlate.sldprt
segspecs/CAD/SolidWorks/victor883/victor8833.sldprt
segspecs/CAD/SolidWorks/12 Inch Wheel/12 Inch Wheel.igs
segspecs/CAD/SolidWorks/3x2bracket_waterjet.SLDDRW
segspecs/CAD/SolidWorks/BB-56012/BB2.igs
segspecs/CAD/SolidWorks/BB-56012/CIM motor-1.sldprt
segspecs/CAD/SolidWorks/BB-56012/CIM motor.sldprt
segspecs/CAD/SolidWorks/Maxi Fuse Block/Maxi Fuse Block.igs
segspecs/CAD/SolidWorks/Victor884/Victor884 Screw Terminal.sldprt
segspecs/CAD/SolidWorks/Victor884/Victor884.igs
segspecs/CAD/SolidWorks/base braket_waterjet.SLDDRW
segspecs/CAD/SolidWorks/base_waterjet.SLDDRW
segspecs/CAD/SolidWorks/battery/battery.igs
segspecs/CAD/SolidWorks/pivot._waterjet.SLDDRW
segspecs/CAD/SolidWorks/plate_waterjet.SLDDRW
segspecs/CAD/SolidWorks/victor883/victor883.igs
segspecs/CAD/segway_waterjet.dxf
