jcarrus/MakeMITSelfBalancingRobot/(commit log)

2014-02-15 Initial state
    [10-24 UNC x 4_ Phillips Pan Head-1.sldprt, 10-24 UNC x 4_ Phillips Pan Head.sldprt, 12 Inch Tire.sldprt, 12 Inch Wheel Inner Hub.sldprt, 12 Inch Wheel Outer Hub.sldprt, 12 Inch Wheel.SLDASM, 12 Inch Wheel.igs, 3x2bracket.SLDPRT]
2014-02-15 Created new file structure
    [10-24 UNC x 4_ Phillips Pan Head-1.sldprt, 10-24 UNC x 4_ Phillips Pan Head.sldprt, 12 Inch Tire.sldprt, 12 Inch Wheel Inner Hub.sldprt, 12 Inch Wheel Outer Hub.sldprt, 12 Inch Wheel.SLDASM, 12 Inch Wheel.igs, 3x2bracket.SLDPRT]
2014-02-15 Changed the control system from servo to DC motor
